tk20dk/arlene/kicad/arlene-pcb.png

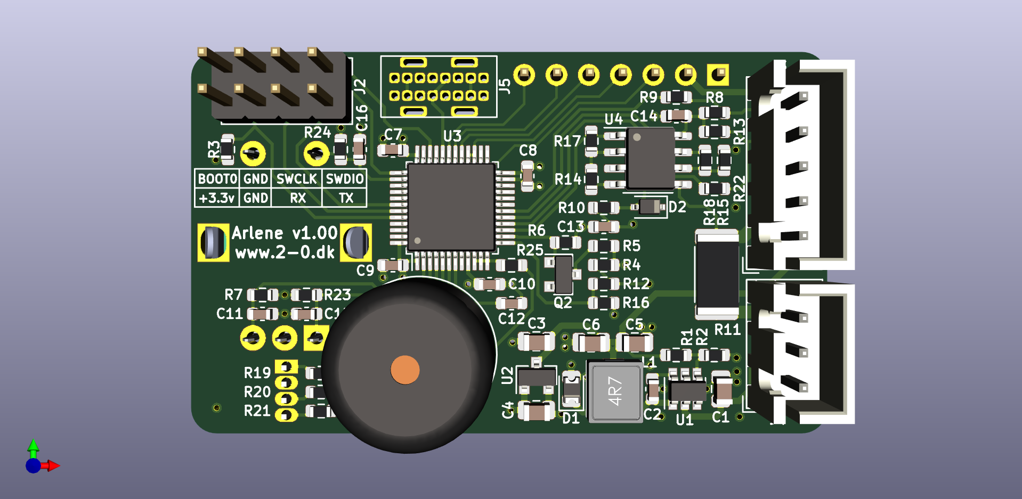
kicad/arlene-pcb.png
