tk20dk/arlene/documents/oled_1.3_spi.jpg

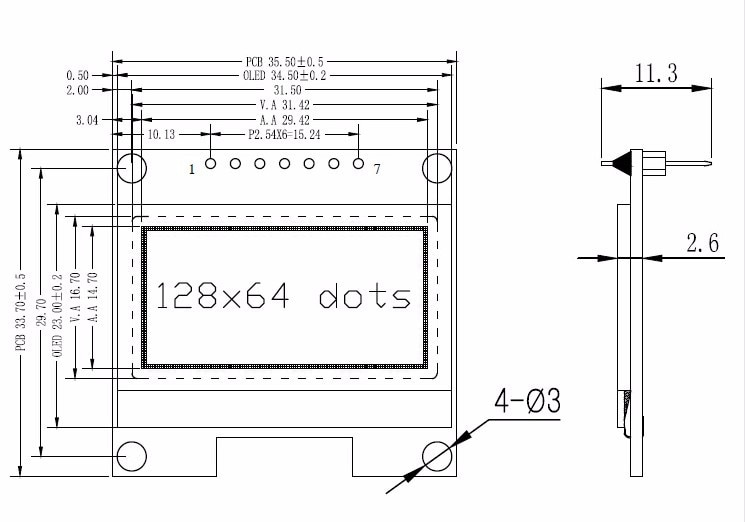
documents/oled_1.3_spi.jpg
