tk20dk/arlene/documents/KSGER STM32 Ver2_1S schematic rev  1_floobydust.pdf

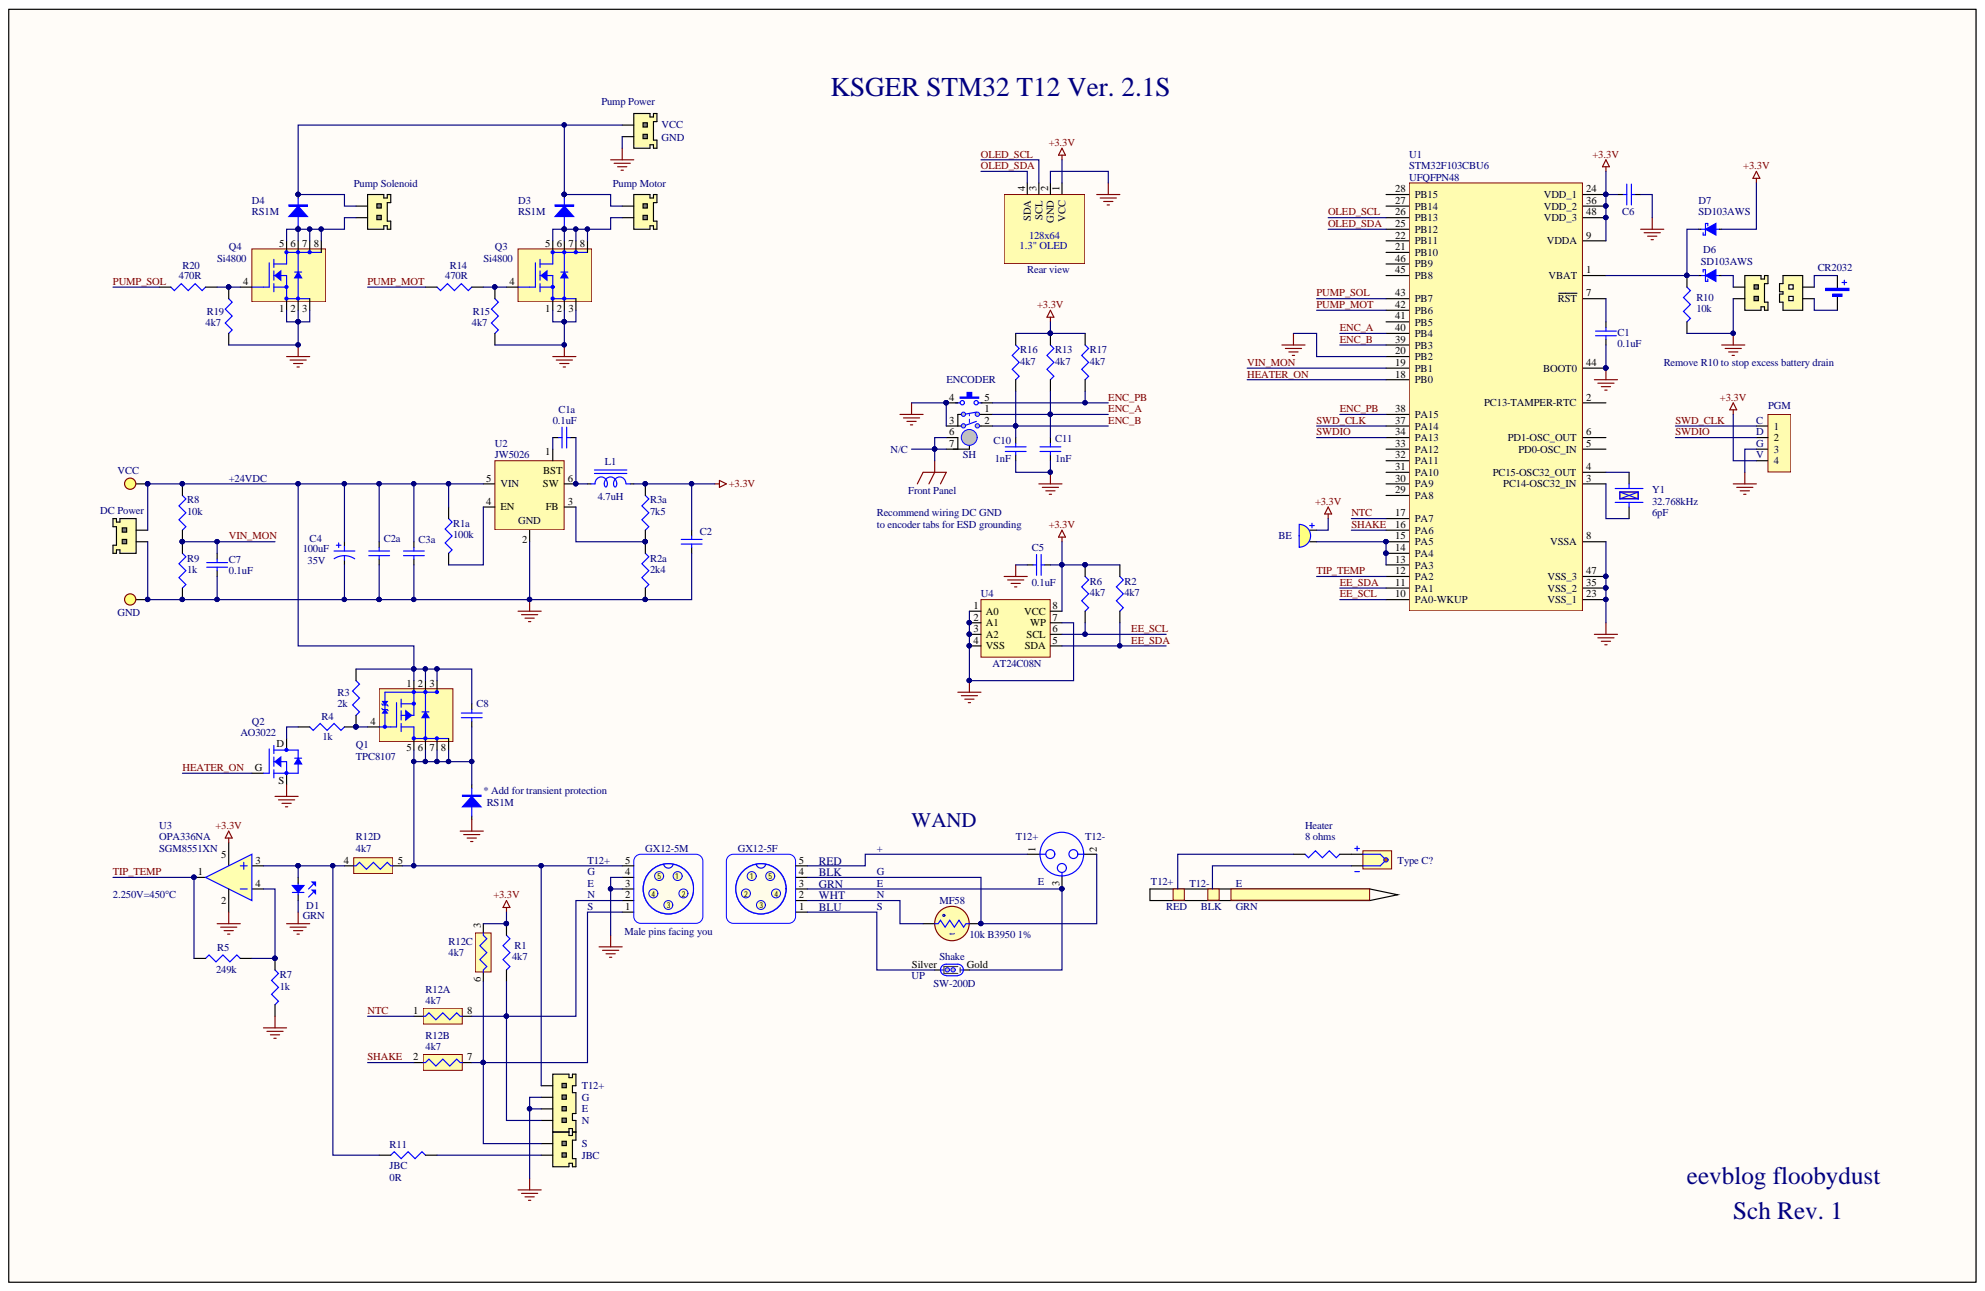
[picture p3: page 1]

Remove R10 to stop excess battery drain

Recommend wiring DC GND
to encoder tabs for ESD grounding

* Add for transient protection

BLK G

Male pins facing you

Silver | 10k B3950 1% Gold Shake
