tk20dk/arlene/kicad/arlene.kicad_pcb

## KiCad design kicad/arlene.kicad_pcb (2021-08-06)

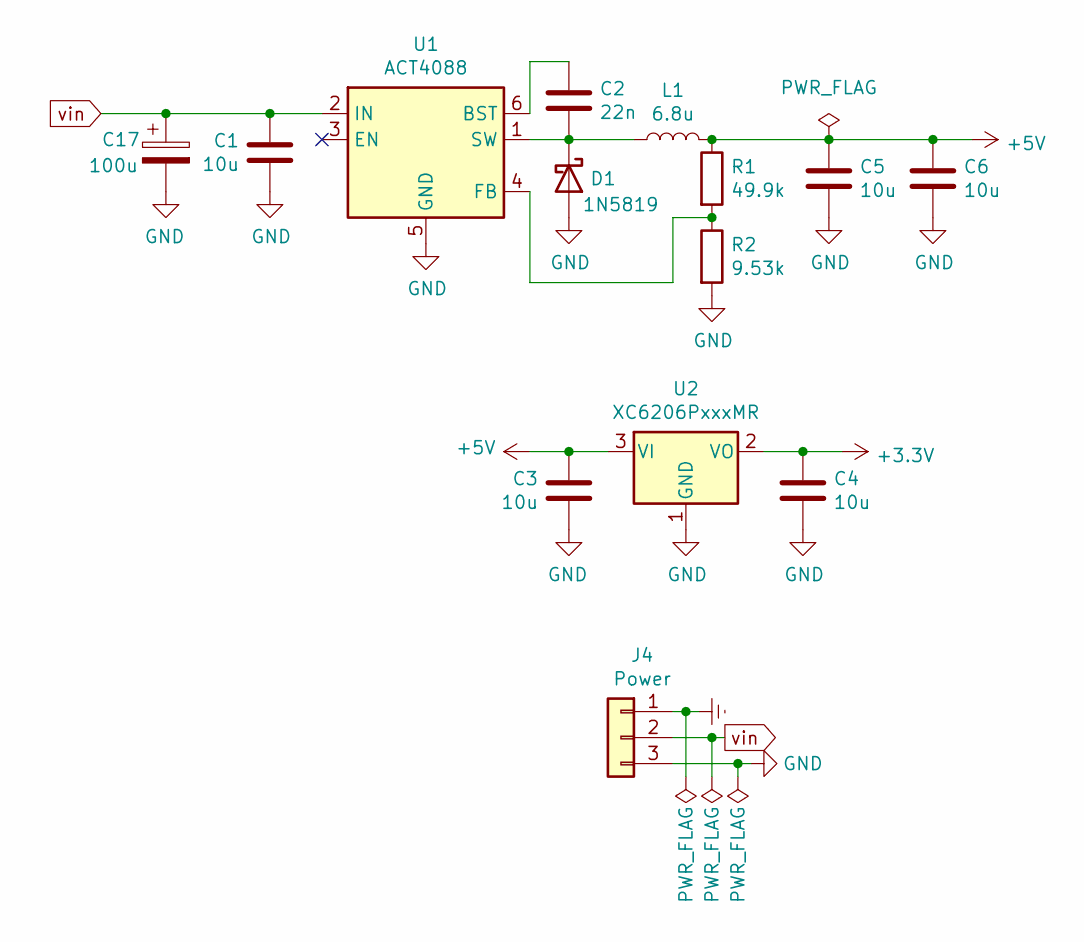
[picture p14: schematic power.sch, Arlene]

Parts:
C1, C3, C4, C5, C6: 10u; C_0805_2012Metric
C2: 22n; C_0603_1608Metric
C17: 100u; CP_EIA-7343-31_Kemet-D
D1: 1N5819; D_0805_2012Metric
J4: Power; JST_XH_B3B-XH-A_1x03_P2.50mm_Vertical
L1: 6.8u; L_4.1x4.1_H1.75
R1: 49.9k; R_0603_1608Metric
R2: 9.53k; R_0603_1608Metric
U1: ACT4088; SOT-23-6
U2: XC6206PxxxMR; SOT-23

Connections:
+5V: C3.1, C5.1, C6.1, L1.2, R1.1, U2.3 (VI); also elsewhere on the board
Earth: J4.1; also elsewhere on the board
GND: C1.2, C3.2, C4.2, C5.2, C6.2, C17.2, D1.2 (A), J4.3, R2.2, U1.5 (GND), U2.1 (GND); also elsewhere on the board
unnamed: C2.1, U1.6 (BST)
unnamed: C2.2, D1.1 (K), L1.1, U1.1 (SW)
unnamed: R1.2, R2.1, U1.4 (FB)
vin: C1.1, C17.1, J4.2, U1.2 (IN); also elsewhere on the board

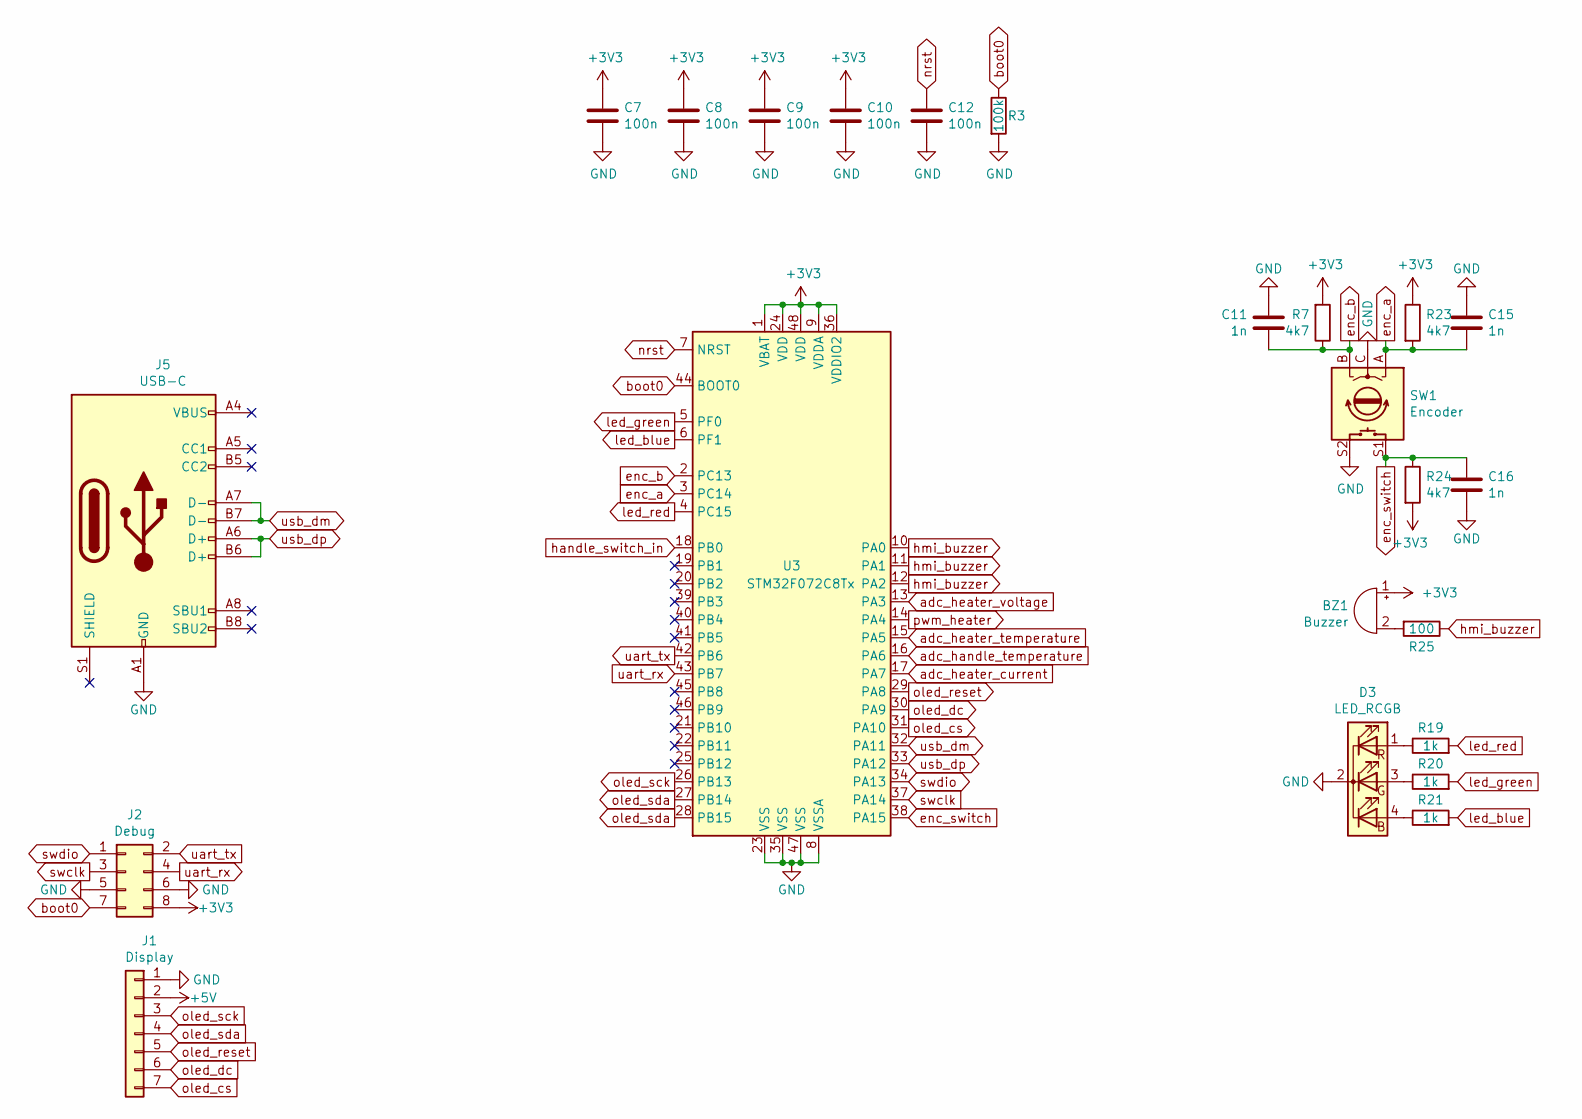
[picture p15: schematic processor.sch, Arlene]

Parts:
BZ1: Buzzer; Buzzer_12x9.5RM7.6
C7, C8, C9, C10, C12: 100n; C_0603_1608Metric
C11, C15, C16: 1n; C_0603_1608Metric
D3: LED_RCGB; LED_D5.0mm-4_RGB
J1: Display; PinHeader_1x07_P2.54mm_Vertical
J2: Debug; PinHeader_2x04_P2.54mm_Vertical
J5: USB-C; usb-c_14pin_tht_vertical
R3: 100k; R_0603_1608Metric
R7, R23, R24: 4k7; R_0603_1608Metric
R19, R20, R21: 1k; R_0603_1608Metric
R25: 100; R_0603_1608Metric
SW1: Encoder; RotaryEncoder_Alps_EC12E-Switch_Vertical_H20mm
U3: STM32F072C8Tx; LQFP-48_7x7mm_P0.5mm

Connections:
+5V: J1.2; also elsewhere on the board
GND: C7.2, C8.2, C9.2, C10.2, C11.2, C12.2, C15.1, C16.2, D3.2 (K), J1.1, J2.5, J2.6, J5.A1 (GND), J5.A12 (GND), J5.B1 (GND), J5.B12 (GND), R3.2, SW1.C, SW1.S2, U3.8 (VSSA), U3.23 (VSS), U3.35 (VSS), U3.47 (VSS); also elsewhere on the board
unnamed: BZ1.2 (+), R25.2
unnamed: D3.1 (RA), R19.1
unnamed: D3.3 (GA), R20.1
unnamed: D3.4 (BA), R21.1
unnamed: J5.A4 (VBUS), J5.A9 (VBUS), J5.B4 (VBUS), J5.B9 (VBUS)
adc_handle_temperature: U3.16 (PA6); also elsewhere on the board
adc_heater_current: U3.17 (PA7); also elsewhere on the board
adc_heater_temperature: U3.15 (PA5); also elsewhere on the board
adc_heater_voltage: U3.13 (PA3); also elsewhere on the board
boot0: J2.7, R3.1, U3.44 (BOOT0)
enc_a: C15.2, R23.2, SW1.A, U3.3 (PC14)
enc_b: C11.1, R7.1, SW1.B, U3.2 (PC13)
enc_switch: C16.1, R24.1, SW1.S1, U3.38 (PA15)
handle_switch_in: U3.18 (PB0); also elsewhere on the board
hmi_buzzer: R25.1, U3.10 (PA0), U3.11 (PA1), U3.12 (PA2)
led_blue: R21.2, U3.6 (PF1)
led_green: R20.2, U3.5 (PF0)
led_red: R19.2, U3.4 (PC15)
nrst: C12.1, U3.7 (NRST)
oled_cs: J1.7, U3.31 (PA10)
oled_dc: J1.6, U3.30 (PA9)
oled_reset: J1.5, U3.29 (PA8)
oled_sck: J1.3, U3.26 (PB13)
oled_sda: J1.4, U3.27 (PB14), U3.28 (PB15)
pwm_heater: U3.14 (PA4); also elsewhere on the board
swclk: J2.3, U3.37 (PA14)
swdio: J2.1, U3.34 (PA13)
uart_rx: J2.4, U3.43 (PB7)
uart_tx: J2.2, U3.42 (PB6)
usb_dm: J5.A7 (D-), J5.B7 (D-), U3.32 (PA11)
usb_dp: J5.A6 (D+), J5.B6 (D+), U3.33 (PA12)

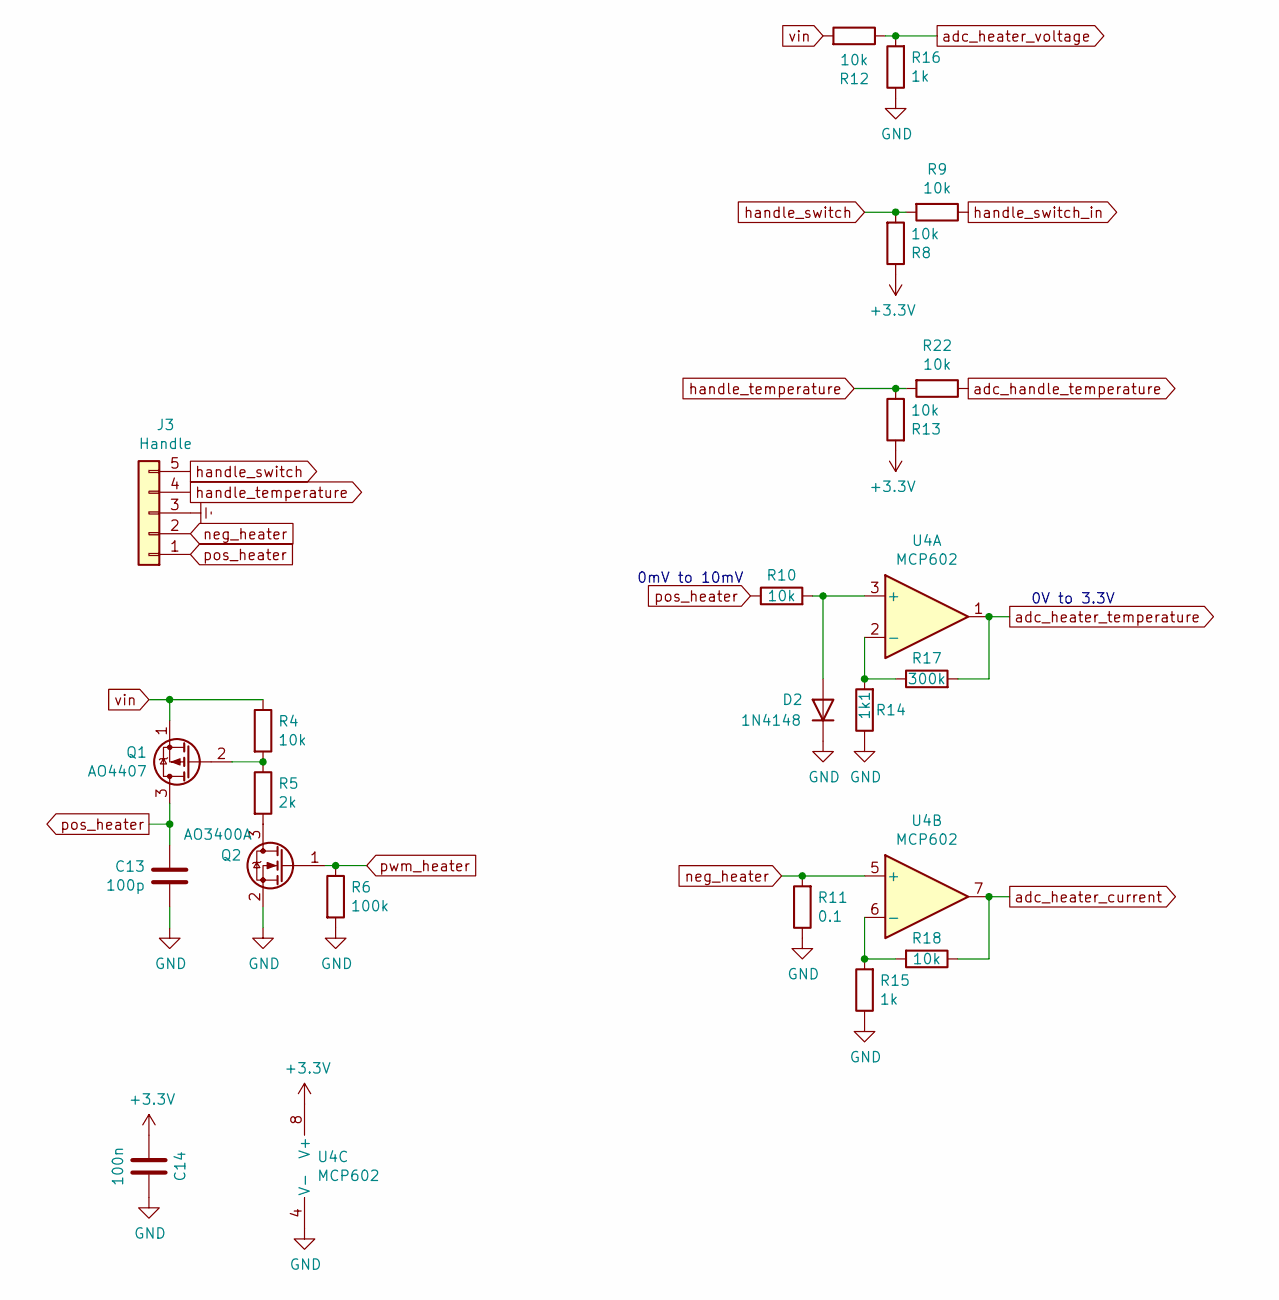
[picture p16: schematic controller.sch, Arlene]

Parts:
C13: 100p; C_0603_1608Metric
C14: 100n; C_0603_1608Metric
D2: 1N4148; D_SOD-323
J3: Handle; JST_XH_B5B-XH-A_1x05_P2.50mm_Vertical
Q1: AO4407; SOIC-8_PMOS_SGD_3.9x4.9mm_P1.27mm
Q2: AO3400A; SOT-23
R4, R8, R9, R10, R12, R13, R18, R22: 10k; R_0603_1608Metric
R5: 2k; R_0603_1608Metric
R6: 100k; R_0603_1608Metric
R11: 0.1; R_2512_6332Metric
R14: 1k1; R_0603_1608Metric
R15, R16: 1k; R_0603_1608Metric
R17: 300k; R_0603_1608Metric
U4: MCP602; SOIC-8_3.9x4.9mm_P1.27mm

Connections:
Earth: J3.3; also elsewhere on the board
GND: C13.2, C14.1, D2.1 (K), Q2.2 (S), R6.2, R11.1, R14.1, R15.1, R16.1, U4.4 (V-); also elsewhere on the board
unnamed: D2.2 (A), R10.2, U4.3 (+)
unnamed: Q1.2 (G), R4.2, R5.1
unnamed: Q2.3 (D), R5.2
unnamed: R14.2, R17.1, U4.2 (-)
unnamed: R15.2, R18.2, U4.6 (-)
adc_handle_temperature: R22.1; also elsewhere on the board
adc_heater_current: R18.1, U4.7; also elsewhere on the board
adc_heater_temperature: R17.2, U4.1; also elsewhere on the board
adc_heater_voltage: R12.1, R16.2; also elsewhere on the board
handle_switch: J3.5, R8.2, R9.2
handle_switch_in: R9.1; also elsewhere on the board
handle_temperature: J3.4, R13.1, R22.2
neg_heater: J3.2, R11.2, U4.5 (+)
pos_heater: C13.1, J3.1, Q1.3 (D), R10.1
pwm_heater: Q2.1 (G), R6.1; also elsewhere on the board
vin: Q1.1 (S), R4.1, R12.2; also elsewhere on the board

Notes on the sheet:
0V to 3.3V
0mV to 10mV

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
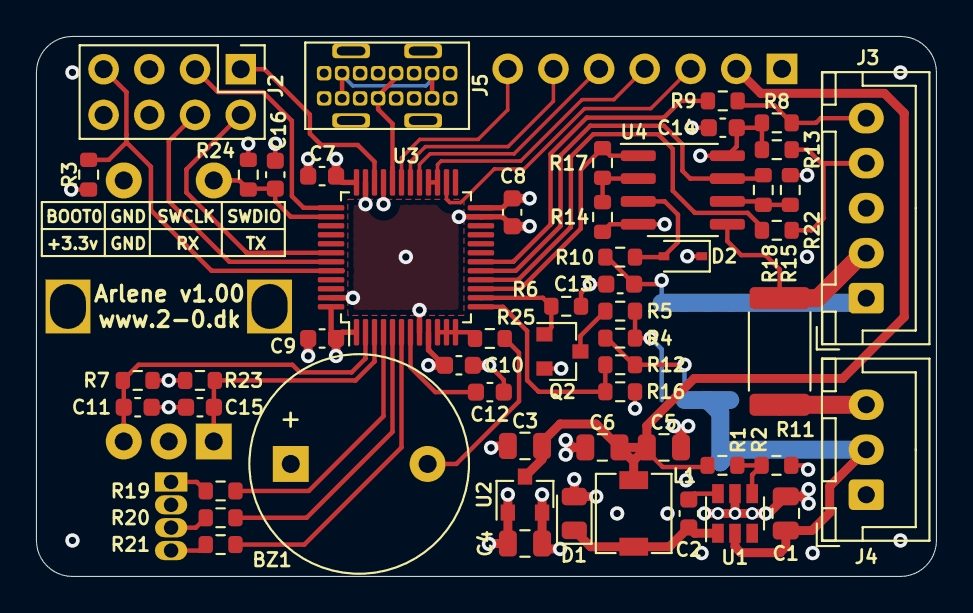
[picture p17: board arlene.kicad_pcb from above]

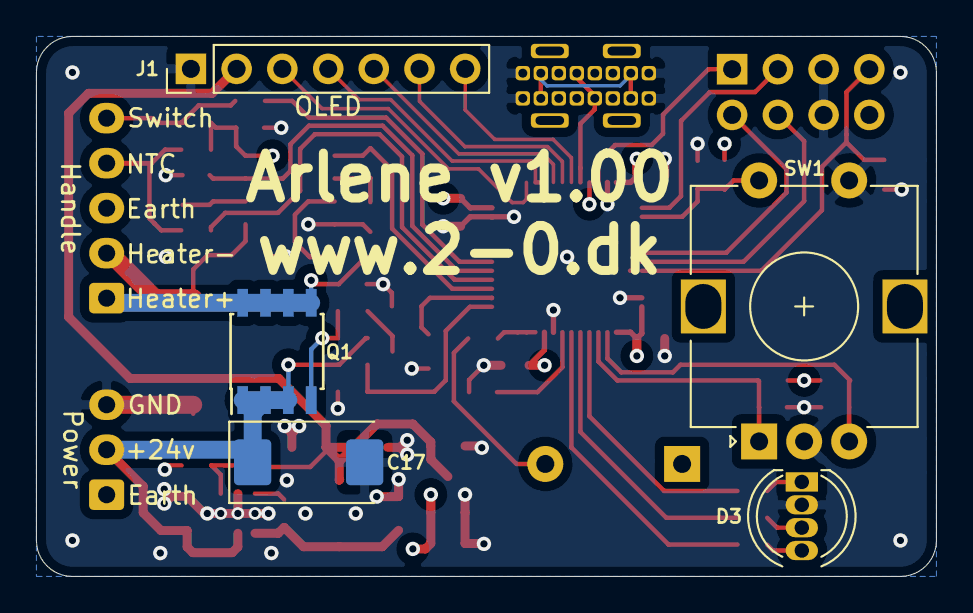
[picture p18: board arlene.kicad_pcb from below]

Board: 4 copper layers, 50.0 x 30.0 mm, 59 parts (5 on the bottom side), 48 nets.
