tk20dk/arlene/documents/ts100-master/Development Resources/TS100/KiCad/MCU_SubBoard.sch

## KiCad design documents/ts100-master/Development Resources/TS100/KiCad/MCU_SubBoard.sch (2020-11-20)

Schematic: MCU_SubBoard.sch

Parts:
C17, C18, C19, C20, C21: 105
C22, C25: 104
C29, C30: 103
R23, R25: 15K
U3: MMA8652FC
U4: STM32F103T8Ux; QFN-36-1EP_6x6mm_Pitch0.5mm
