tk20dk/arlene/documents/ts100-master/Development Resources/TS100/KiCad/TS100.sch

## KiCad design documents/ts100-master/Development Resources/TS100/KiCad/TS100.sch (2020-11-20)

Schematic: TS100.sch

Parts:
J101: BARREL_JACK
SW1, SW101: SW_Push
