tk20dk/arlene/documents/ts100-master/Development Resources/TS80/TS80.ioc

Mcu.UserName=STM32F103T8Ux
PA0-WKUP.GPIO_Label=RM
PA0-WKUP.Signal=GPIO_Output
PA10.GPIO_Label=QC_DM_11K
PA10.Signal=GPIO_Output
PA11.GPIO_Label=USB_DM
PA11.Signal=GPIO_Analog
PA12.GPIO_Label=USB_DP
PA12.Signal=GPIO_Analog
PA13.GPIO_Label=QC_DP_SENSE
PA13.Signal=GPIO_Input
PA14.GPIO_Label=QC_DM_SENSE
PA14.Signal=GPIO_Input
PA15.GPIO_Label=OLED_RESET
PA15.Signal=GPIO_Output
PA2.GPIO_Label=ADC_VIN
PA2.Signal=ADCx_IN2
PA3.GPIO_Label=ADC_TIP
PA3.Signal=ADCx_IN3
PA4.GPIO_Label=ADC_TMP36
PA4.Signal=ADCx_IN4
PA6.GPIO_Label=PWM Out
PA6.Signal=S_TIM3_CH1
PA8.GPIO_Label=QC_DM_3K
PA8.Signal=GPIO_Output
PA9.GPIO_Label=MODEL_SEL
PA9.Signal=GPIO_Input
PB0.GPIO_Label=KEY_A
PB0.Signal=GPIO_Input
PB1.GPIO_Label=KEY_B
PB1.Signal=GPIO_Input
PB3.GPIO_Label=QC_DP_3K
PB3.Signal=GPIO_Output
PB4.GPIO_Label=IMU_INT2
PB4.Signal=GPXTI4
PB5.GPIO_Label=IMU_INT1
PB5.Signal=GPXTI5
PB6.GPIO_Label=SCL
PB6.Signal=I2C1_SCL
PB7.GPIO_Label=SDA
PB7.Signal=I2C1_SDA
