tk20dk/arlene/stm32/Core/Inc/main.h

#define HANDLE_SWITCH_Pin GPIO_PIN_4
#define HANDLE_SWITCH_GPIO_Port GPIOA
#define HANDLE_SWITCH_EXTI_IRQn EXTI4_15_IRQn
#define PWM_HEATER_Pin GPIO_PIN_5
#define PWM_HEATER_GPIO_Port GPIOA
#define HMI_BUZZER_Pin GPIO_PIN_6
#define HMI_BUZZER_GPIO_Port GPIOA
#define ENC_SWITCH_Pin GPIO_PIN_7
#define ENC_SWITCH_GPIO_Port GPIOA
#define ENC_SWITCH_EXTI_IRQn EXTI4_15_IRQn
#define ENC_B_Pin GPIO_PIN_12
#define ENC_B_GPIO_Port GPIOB
#define ENC_B_EXTI_IRQn EXTI4_15_IRQn
#define ENC_A_Pin GPIO_PIN_13
#define ENC_A_GPIO_Port GPIOB
#define ENC_A_EXTI_IRQn EXTI4_15_IRQn
#define LED2_GREEN_Pin GPIO_PIN_14
#define LED2_GREEN_GPIO_Port GPIOB
#define LED2_RED_Pin GPIO_PIN_15
#define LED2_RED_GPIO_Port GPIOB
#define LED2_BLUE_Pin GPIO_PIN_8
#define LED2_BLUE_GPIO_Port GPIOA
#define LED1_RED_Pin GPIO_PIN_15
#define LED1_RED_GPIO_Port GPIOA
#define LED1_GREEN_Pin GPIO_PIN_3
#define LED1_GREEN_GPIO_Port GPIOB
#define LED1_BLUE_Pin GPIO_PIN_4
#define LED1_BLUE_GPIO_Port GPIOB
