tk20dk/arlene/(commit log)

2020-11-20 created initial kicad and stm32 and stm32 projects
    [F1-T12_complete.sch, F1-T12_heater.sch, F1-T12_sensor.sch, MCU_SubBoard.sch, TS100.sch, arlene Debug.cfg, arlene.kicad_pcb, arlene.sch]
2021-07-29 updated project to STM32CudeIDE 1.6.1
    [F1-T12_complete.sch, F1-T12_heater.sch, F1-T12_sensor.sch, arlene Debug.cfg, handle.sch, heater.sch, sensor.sch, stm32_hakko.sch]
2021-08-01 updated controller
    [controller.sch]
2021-08-05 Arlene v1.00
    [arlene-B_Cu.gbr, arlene-B_Mask.gbr, arlene-B_SilkS.gbr, arlene-Edge_Cuts.gbr, arlene-F_Cu.gbr, arlene-F_Mask.gbr, arlene-F_SilkS.gbr, arlene-In1_Cu.gbr]
2021-08-06 JLCPCB exit!
    [arlene-B_Cu.gbr, arlene-B_Mask.gbr, arlene-B_SilkS.gbr, arlene-Edge_Cuts.gbr, arlene-F_Cu.gbr, arlene-F_Mask.gbr, arlene-F_SilkS.gbr, arlene-In1_Cu.gbr]
